acidbourbon/6N2P_amp/6N2P_amp.pdf

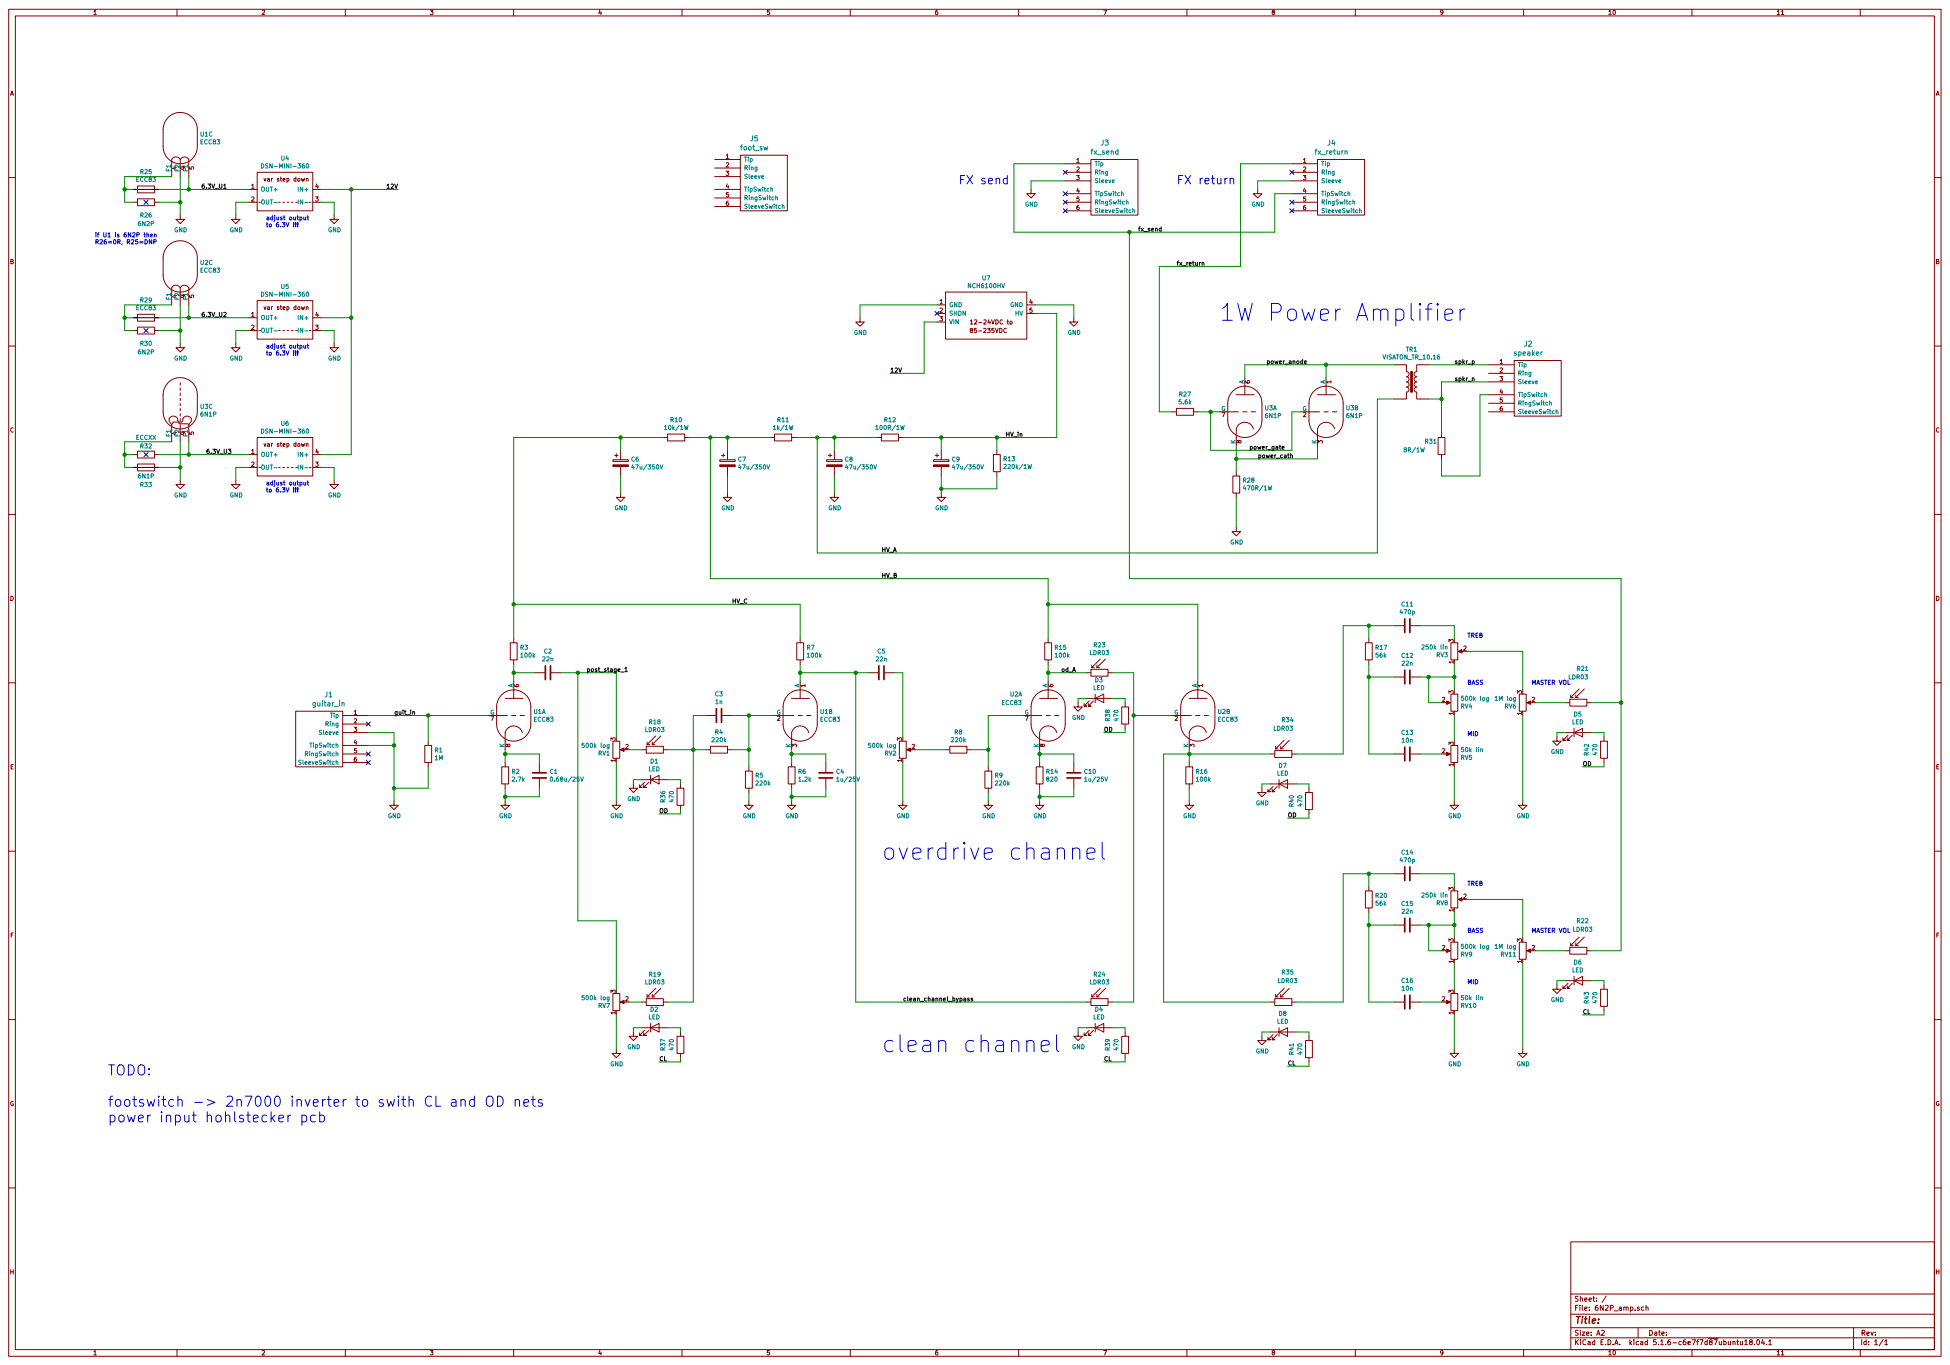
[picture p1: page 1]

if U1 is 6N2P then R26=0R, R25=DNP

MASTER VOL BASS TODO:

footswitch -> 2n7000 inverter to swith CL and OD nets
power input hohlstecker pcb
