acidbourbon/6N2P_amp/6N2P_amp.kicad_pcb

## KiCad design 6N2P_amp.kicad_pcb (2021-04-18)

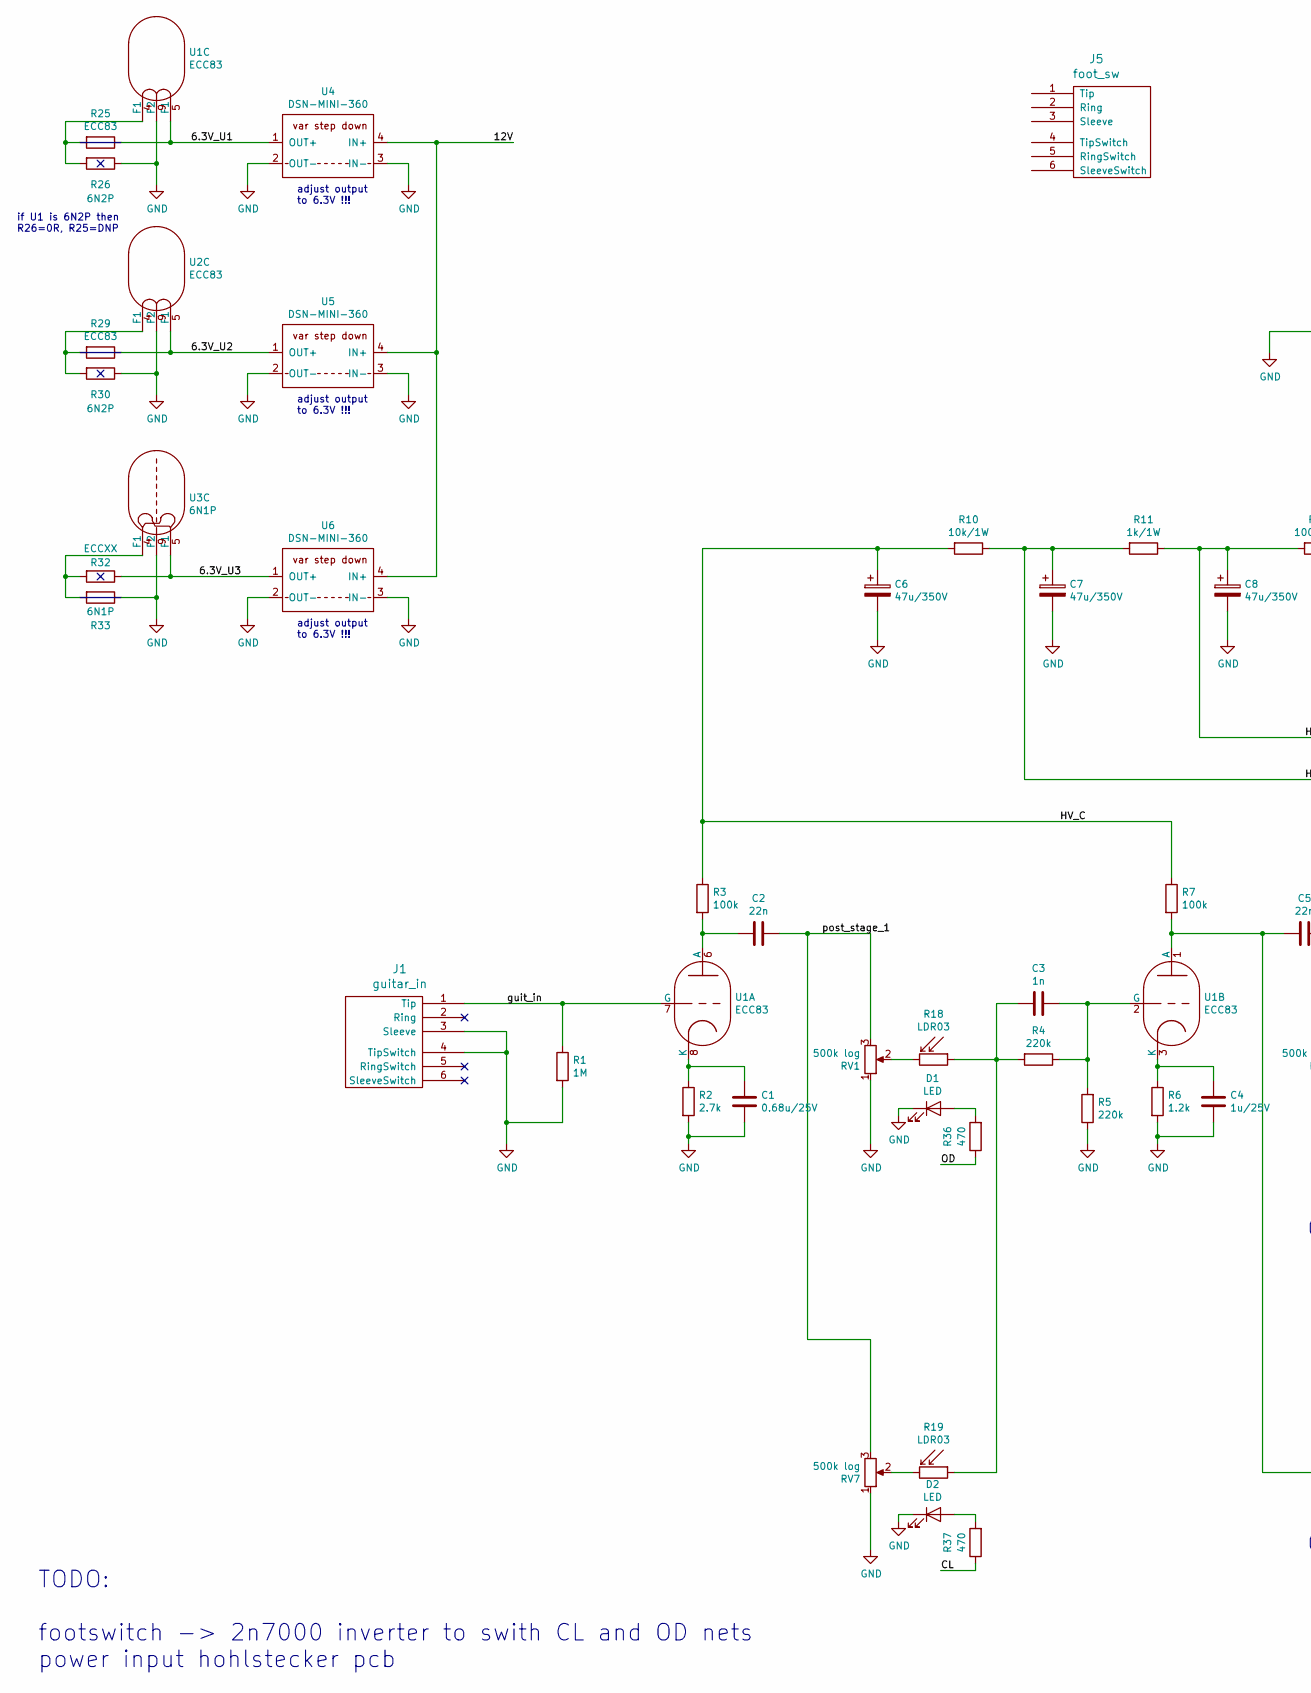
[picture p2: schematic 6N2P_amp.sch, part in row 1, column 1]

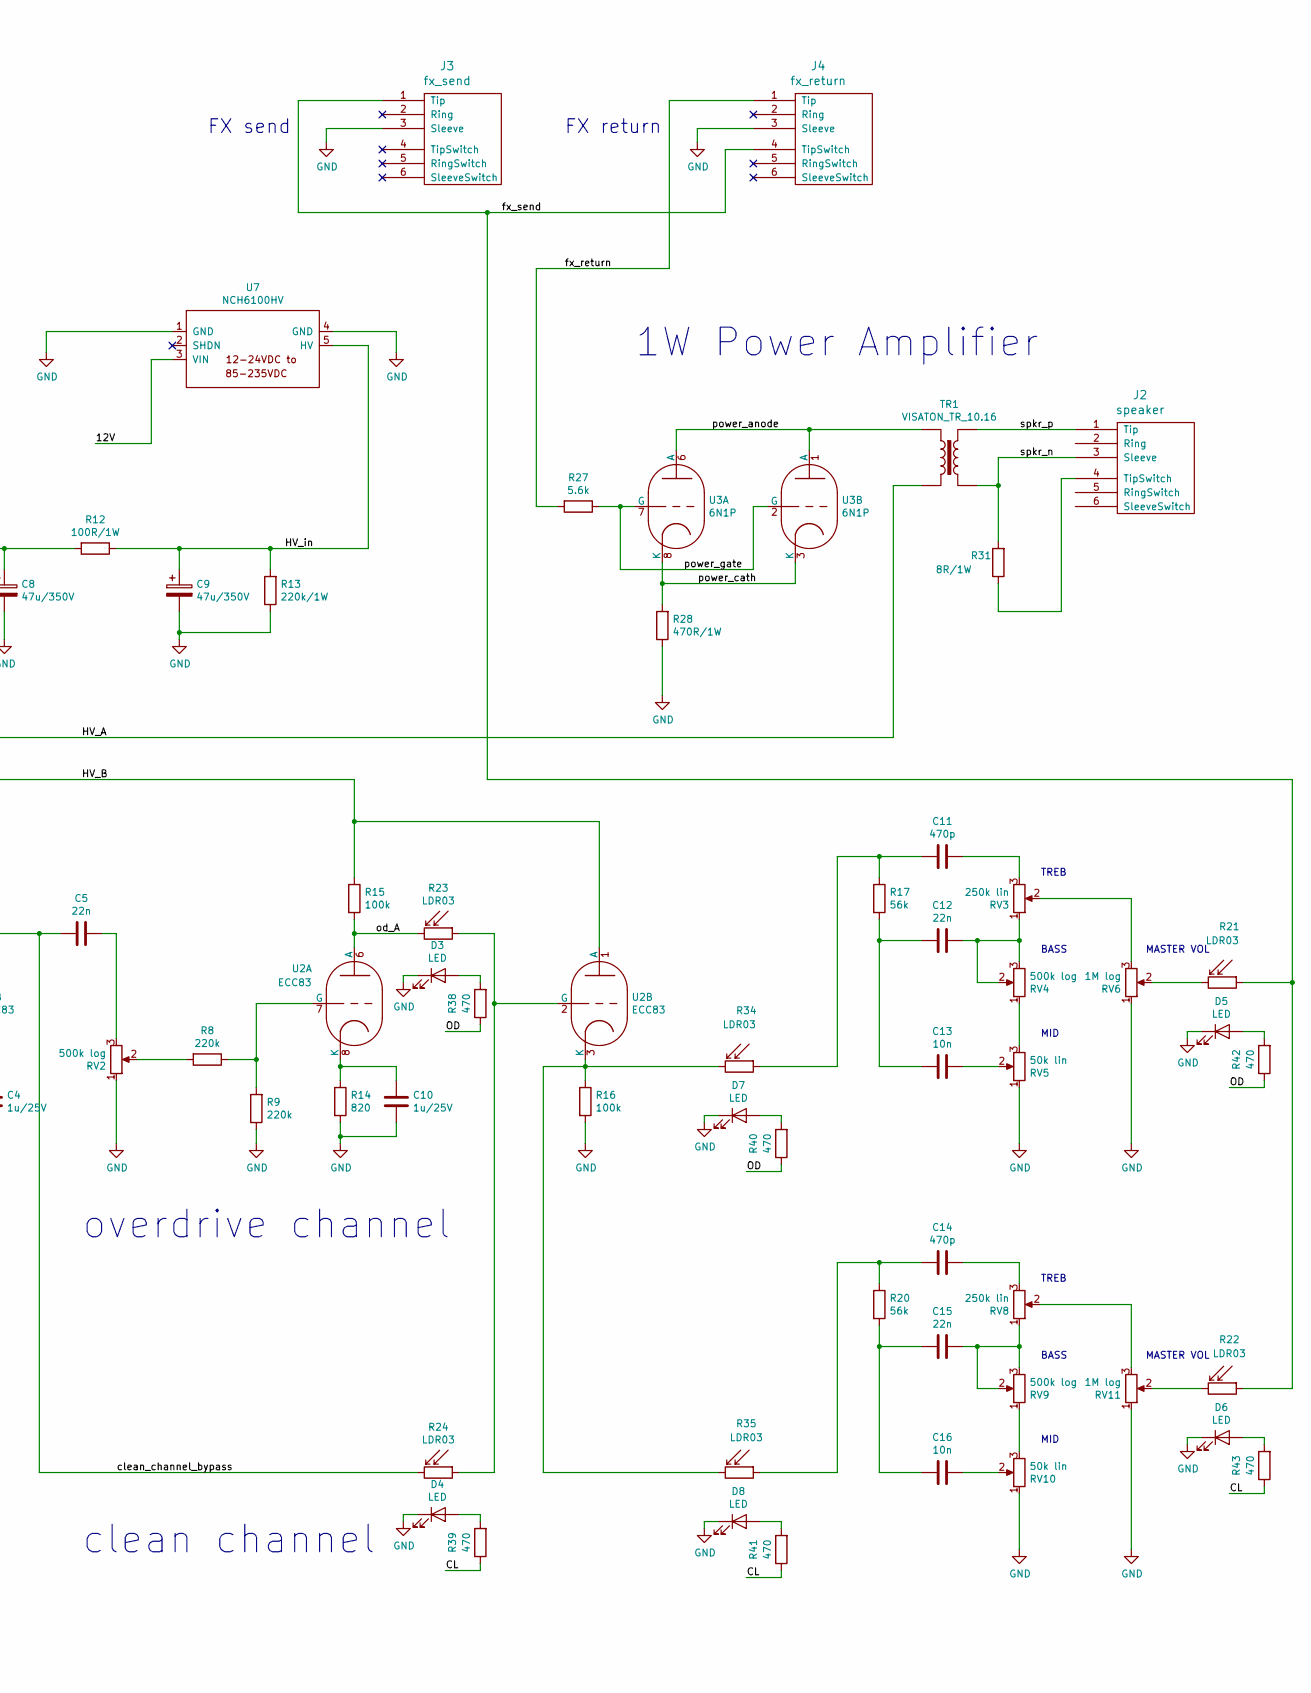
[picture p3: schematic 6N2P_amp.sch, part in row 1, column 2]

Parts:
C1: 0.68u/25V; C_Rect_L9.0mm_W4.0mm_P7.50mm_MKT
C2, C5, C12, C15: 22n; C_Rect_L9.0mm_W4.0mm_P7.50mm_MKT
C3: 1n; C_Rect_L9.0mm_W4.0mm_P7.50mm_MKT
C4, C10: 1u/25V; C_Rect_L9.0mm_W4.0mm_P7.50mm_MKT
C6, C7, C8, C9: 47u/350V; CP_Radial_D16.0mm_P7.50mm
C11, C14: 470p; C_Rect_L9.0mm_W4.0mm_P7.50mm_MKT
C13, C16: 10n; C_Rect_L9.0mm_W4.0mm_P7.50mm_MKT
D1, D2, D3, D4, D5, D6, D7, D8: LED; LED_D5.0mm
J1: guitar_in; Reichelt_EBS63P
J2: speaker; Reichelt_EBS63P
J3: fx_send; Reichelt_EBS63P
J4: fx_return; Reichelt_EBS63P
J5: foot_sw; Reichelt_EBS63P
R1: 1M; R_Axial_DIN0207_L6.3mm_D2.5mm_P10.16mm_Horizontal
R2: 2.7k; R_Axial_DIN0207_L6.3mm_D2.5mm_P10.16mm_Horizontal
R3, R7, R15, R16: 100k; R_Axial_DIN0207_L6.3mm_D2.5mm_P10.16mm_Horizontal
R4, R5, R8, R9: 220k; R_Axial_DIN0207_L6.3mm_D2.5mm_P10.16mm_Horizontal
R6: 1.2k; R_Axial_DIN0207_L6.3mm_D2.5mm_P10.16mm_Horizontal
R10: 10k/1W; R_Axial_DIN0207_L6.3mm_D2.5mm_P10.16mm_Horizontal
R11: 1k/1W; R_Axial_DIN0207_L6.3mm_D2.5mm_P10.16mm_Horizontal
R12: 100R/1W; R_Axial_DIN0207_L6.3mm_D2.5mm_P10.16mm_Horizontal
R13: 220k/1W; R_Axial_DIN0207_L6.3mm_D2.5mm_P10.16mm_Horizontal
R14: 820; R_Axial_DIN0207_L6.3mm_D2.5mm_P10.16mm_Horizontal
R17, R20: 56k; R_Axial_DIN0207_L6.3mm_D2.5mm_P10.16mm_Horizontal
R18, R19, R21, R22, R23, R24, R34, R35: LDR03; R_LDR_4.9x4.2mm_P2.54mm_Vertical
R25, R29: ECC83; R_Axial_DIN0204_L3.6mm_D1.6mm_P2.54mm_Vertical
R26, R30: 6N2P; R_Axial_DIN0204_L3.6mm_D1.6mm_P2.54mm_Vertical
R27: 5.6k; R_Axial_DIN0207_L6.3mm_D2.5mm_P10.16mm_Horizontal
R28: 470R/1W; R_Axial_DIN0207_L6.3mm_D2.5mm_P10.16mm_Horizontal
R31: 8R/1W; R_Axial_DIN0207_L6.3mm_D2.5mm_P10.16mm_Horizontal
R32: ECCXX; R_Axial_DIN0204_L3.6mm_D1.6mm_P2.54mm_Vertical
R33: 6N1P; R_Axial_DIN0204_L3.6mm_D1.6mm_P2.54mm_Vertical
R36, R37, R38, R39, R40, R41, R42, R43: 470; R_Axial_DIN0309_L9.0mm_D3.2mm_P2.54mm_Vertical
RV1, RV2, RV4: 500k log; PinHeader_1x03_P2.54mm_Vertical
RV3: 250k lin; PinHeader_1x03_P2.54mm_Vertical
RV5: 50k lin; PinHeader_1x03_P2.54mm_Vertical
RV6: 1M log; PinHeader_1x03_P2.54mm_Vertical
RV7, RV9: 500k log; Potentiometer_Alps_RK163_Single_Horizontal
RV8: 250k lin; Potentiometer_Alps_RK163_Single_Horizontal
RV10: 50k lin; Potentiometer_Alps_RK163_Single_Horizontal
RV11: 1M log; Potentiometer_Alps_RK163_Single_Horizontal
TR1: VISATON_TR_10.16
U1, U2: ECC83; tube_gzc9-b
U3: 6N1P; socket_gzc9-b
U4, U5, U6: DSN-MINI-360
U7: NCH6100HV

Connections:
/6.3V_U1: R25.1, U1.5 (F1), U4.1 (OUT+)
/6.3V_U2: R29.1, U2.5 (F1), U5.1 (OUT+)
/6.3V_U3: R32.1, U3.5 (F1), U6.1 (OUT+)
/12V: U4.4 (IN+), U5.4 (IN+), U6.4 (IN+), U7.3 (VIN)
/CL: R37.1, R39.1, R41.1, R43.1
/HV_A: C8.1, R11.1, R12.2, TR1.2
/HV_B: C7.1, R10.1, R11.2, R15.1, U2.1 (A)
/HV_C: C6.1, R3.1, R7.1, R10.2
/HV_in: C9.1, R12.1, R13.2, U7.5 (HV)
/OD: R36.1, R38.1, R40.1, R42.1
/clean_channel_bypass: C5.2, R7.2, R24.2, U1.1 (A)
/fx_return: J4.1 (Tip), R27.2
/fx_send: J3.1 (Tip), J4.4 (TipSwitch), R21.1, R22.1
/guit_in: J1.1 (Tip), R1.1, U1.7 (G)
/od_A: R15.2, R23.2, U2.6 (A)
/post_stage_1: C2.1, RV1.3, RV7.3
/power_anode: TR1.1, U3.1 (A), U3.6 (A)
/power_cath: R28.2, U3.3 (K), U3.8 (K)
/power_gate: R27.1, U3.2 (G), U3.7 (G)
/spkr_n: J2.3 (Sleeve), R31.2, TR1.3
/spkr_p: J2.1 (Tip), TR1.4
GND: C1.2, C4.2, C6.2, C7.2, C8.2, C9.2, C10.2, D1.1 (K), D2.1 (K), D3.1 (K), D4.1 (K), D5.1 (K), D6.1 (K), D7.1 (K), D8.1 (K), J1.3 (Sleeve), J1.4 (TipSwitch), J3.3 (Sleeve), J4.3 (Sleeve), R1.2, R2.2, R5.1, R6.2, R9.1, R13.1, R14.2, R16.2, R26.1, R28.1, R30.1, R33.1, RV1.1, RV2.1, RV5.1, RV6.1, RV7.1, RV10.1, RV11.1, U1.9 (F2), U2.9 (F2), U3.9 (F2), U4.2 (OUT-), U4.3 (IN-), U5.2 (OUT-), U5.3 (IN-), U6.2 (OUT-), U6.3 (IN-), U7.1 (GND), U7.4 (GND)
unnamed: C1.1, R2.1, U1.8 (K)
unnamed: C2.2, R3.2, U1.6 (A)
unnamed: C3.1, R4.1, R5.2, U1.2 (G)
unnamed: C3.2, R4.2, R18.1, R19.1
unnamed: C4.1, R6.1, U1.3 (K)
unnamed: C5.1, RV2.3
unnamed: C10.1, R14.1, U2.8 (K)
unnamed: C11.1, RV3.3
unnamed: C11.2, R17.1, R34.1
unnamed: C12.1, RV3.1, RV4.2, RV4.3
unnamed: C12.2, C13.2, R17.2
unnamed: C13.1, RV5.2
unnamed: C14.1, RV8.3
unnamed: C14.2, R20.1, R35.1
unnamed: C15.1, RV8.1, RV9.2, RV9.3
unnamed: C15.2, C16.2, R20.2
unnamed: C16.1, RV10.2
unnamed: D1.2 (A), R36.2
unnamed: D2.2 (A), R37.2
unnamed: D3.2 (A), R38.2
unnamed: D4.2 (A), R39.2
unnamed: D5.2 (A), R42.2
unnamed: D6.2 (A), R43.2
unnamed: D7.2 (A), R40.2
unnamed: D8.2 (A), R41.2
unnamed: J2.4 (TipSwitch), R31.1
unnamed: R8.1, R9.2, U2.7 (G)
unnamed: R8.2, RV2.2
unnamed: R16.1, R34.2, R35.2, U2.3 (K)
unnamed: R18.2, RV1.2
unnamed: R19.2, RV7.2
unnamed: R21.2, RV6.2
unnamed: R22.2, RV11.2
unnamed: R23.1, R24.1, U2.2 (G)
unnamed: R25.2, R26.2, U1.4 (F1)
unnamed: R29.2, R30.2, U2.4 (F1)
unnamed: R32.2, R33.2, U3.4 (F1)
unnamed: RV3.2, RV6.3
unnamed: RV4.1, RV5.3
unnamed: RV9.1, RV10.3
unnamed: RV8.2, RV11.3

Notes on the sheet:
TREB
BASS
MID
MASTER VOL
clean channel
overdrive channel
if U1 is 6N2P then R26=0R, R25=DNP
1W Power Amplifier
FX send
FX return
adjust output to 6.3V !!!
TODO: footswitch -> 2n7000 inverter to swith CL and OD nets power input hohlstecker pcb

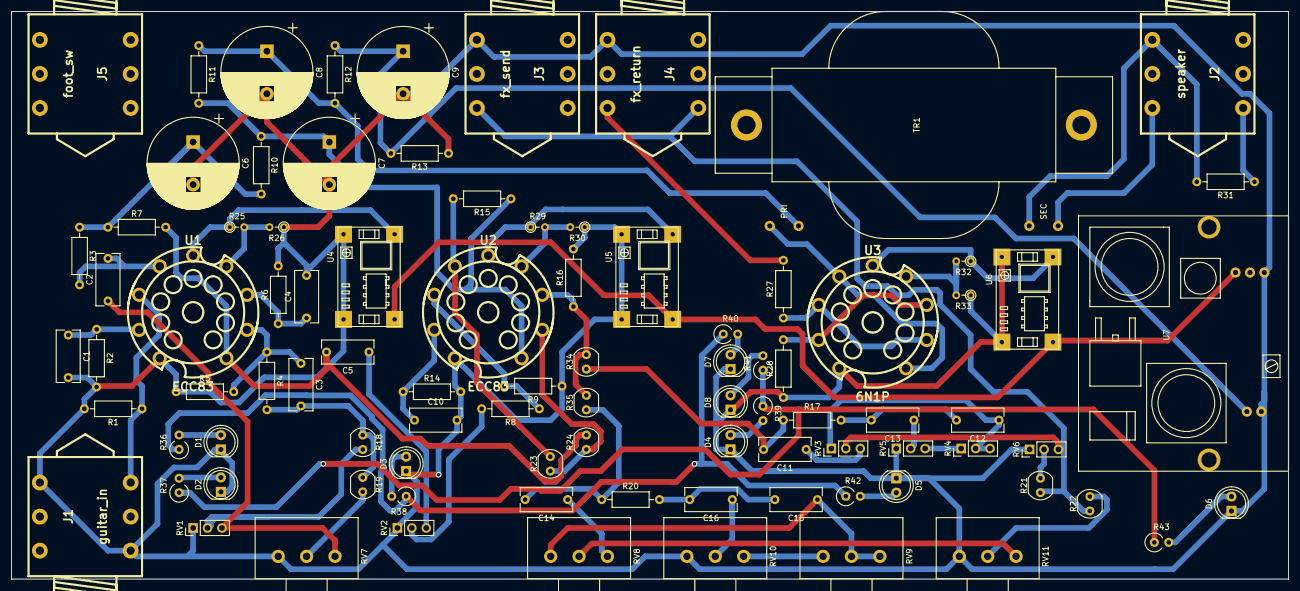
[picture p4: board 6N2P_amp.kicad_pcb from above]

Board: 2 copper layers, 225.0 x 100.0 mm, 91 parts (0 on the bottom side), 63 nets.
