acidbourbon/6N2P_amp/(commit log)

2020-04-19 it is making progress
    [6N2P_amp.sch]
2020-04-26 some progress ... made symbols for dc dc converters and transformer
    [6N2P_amp.sch]
2020-08-24 snap, ... started experimental routing
    [6N2P_amp.kicad_pcb, 6N2P_amp.sch]
2020-08-24 help text in layout
    [6N2P_amp.kicad_pcb]
2020-08-24 added the ldr leds
    [6N2P_amp.kicad_pcb, 6N2P_amp.sch]
2020-08-24 introduced foot switch jack
    [6N2P_amp.kicad_pcb, 6N2P_amp.sch]
2020-08-24 genug fuer heute
    [6N2P_amp.kicad_pcb, 6N2P_amp.sch]
2020-08-25 more LDRs
    [6N2P_amp.sch]
2020-08-25 more routing
    [6N2P_amp.kicad_pcb]
2020-08-26 new evening
    [6N2P_amp.kicad_pcb, 6N2P_amp.sch]
2020-08-26 we have resistors now for the LEDs
    [6N2P_amp.kicad_pcb, 6N2P_amp.sch]
2020-08-26 resistors and spacings
    [6N2P_amp.kicad_pcb, 6N2P_amp.sch]
2020-08-26 everything routed. woah!
    [6N2P_amp.kicad_pcb]
2021-04-18 pdf of schematic
    [6N2P_amp.kicad_pcb]
